Mahou-Iryoku/Robot_DUT_Electronic_Project/Robot_suiveur_de_ligne/config_1.txt

#define LED_GAUCHE LATBbits.LATB3
#define LED_MILIEU LATBbits.LATB4
#define LED_DROITE LATBbits.LATB5
#define EMIR_D LATBbits.LATB0
#define EMIR_M LATBbits.LATB1
#define EMIR_G LATBbits.LATB2
